ayuusweetfish/Tuengel/misc/protocol.txt

Packet format
[1 byte] Payload length (n)
[n byte] Payload
[4 byte] CRC-32 0x04C11DB7 little-endian

(All offsets hexadecimal)

Serial - L0
Ping
  +00 [0x55] Ping
  Response
    +00 [0xAA] Pong
    For n in 0~4
    +3n+01 Bitmask  7~ 0
    +3n+02 Bitmask 15~ 8
    +3n+03 Bitmask 23~16
Strike
  +00 [0x00~0x3F] Out addr (L1)
  +01 [0x00~0x3F] Out addr (U)
  +02 Velocity
  Response
    +00 [0xAA] Done
        [0xAB] Another operation in progress, ignored
        [0xED] Timeout/error at downstream
        [0xEE] Timeout/error

L0 - L1
Ping
  +00 [0x55] Ping
  Response
    +00 [0xAA] Pong
    +01 Bitmask  7~ 0
    +02 Bitmask 15~ 8
    +03 Bitmask 23~16
Strike
  +00 [0x00~0x3F] Out addr (U)
  +01 Velocity
  Response
    +00 [0xAA] Done
        [0xAB] Another operation in progress, ignored
        [0xEE] Timeout/error

L1 - U
Ping
+00 [0x55] Ping
  Response
    +00 [0xAA] Pong
    +01..10 UID
Strike
  +00 [0x01] Strike
  +01 Velocity
  Response
    +00 [0xAA] Done
        [0xAB] Another operation in progress, ignored
