ayuusweetfish/Tuengel/unit_hw/Case_Unit.kicad_pcb

## KiCad design unit_hw/Case_Unit.kicad_pcb (2024-10-16)

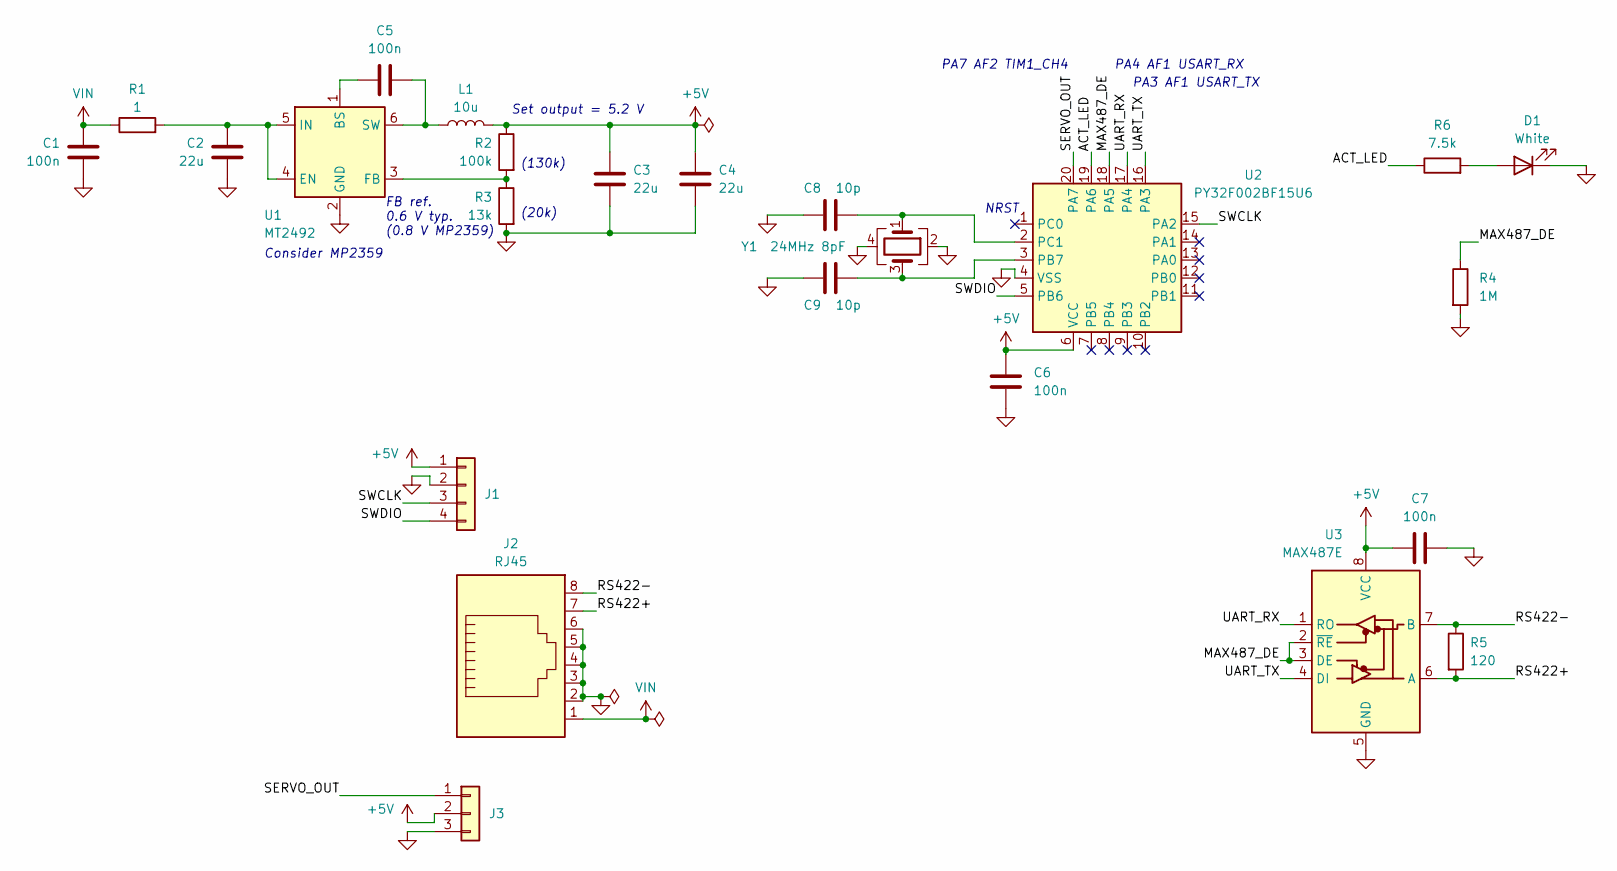
[picture p1: schematic Case_Unit.kicad_sch]

Parts:
C1, C5, C6, C7: 100n; C_0402_1005Metric
C2, C3, C4: 22u; C_0603_1608Metric
C8, C9: 10p; C_0402_1005Metric
D1: White; LED_0603_1608Metric
J1: Conn_01x04; TestPoints_1x04_P2.0
J2: RJ45; RJ45_OST_PJ012-8P8CX_Vertical
J3: Conn_01x03; PinHeader_1x03_P2.54mm_Vertical
L1: 10u; L_Changjiang_FNR5030S
R1: 1; R_0402_1005Metric
R2: 100k; R_0402_1005Metric
R3: 13k; R_0402_1005Metric
R4: 1M; R_0402_1005Metric
R5: 120; R_0402_1005Metric
R6: 7.5k; R_0402_1005Metric
U1: MT2492; SOT-23-6; Manufacturer_Part_Number MT2492
U2: PY32F002BF15U6; QFN-20-1EP_3x3mm_P0.4mm_EP1.65x1.65mm
U3: MAX487E; SOIC-8_3.9x4.9mm_P1.27mm
Y1: 24MHz 8pF; Crystal_SMD_2016-4Pin_2.0x1.6mm

Connections:
+5V: C3.1, C4.1, C6.1, C7.1, J1.1, J3.2, L1.2, R2.1, U2.6 (VCC), U3.8 (VCC)
/ACT_LED: R6.1, U2.19 (PA6)
/MAX487_DE: R4.1, U2.18 (PA5), U3.2 (~RE), U3.3 (DE)
/RS422+: J2.7, R5.2, U3.6 (A)
/RS422-: J2.8, R5.1, U3.7 (B)
/SERVO_OUT: J3.1, U2.20 (PA7)
/SWCLK: J1.3, U2.15 (PA2)
/SWDIO: J1.4, U2.5 (PB6)
/UART_RX: U2.17 (PA4), U3.1 (RO)
/UART_TX: U2.16 (PA3), U3.4 (DI)
GND: C1.2, C2.2, C3.2, C4.2, C6.2, C7.2, C8.1, C9.1, D1.1 (K), J1.2, J2.2, J2.3, J2.4, J2.5, J2.6, J3.3, R3.2, R4.2, U1.2 (GND), U2.4 (VSS), U2.21 (PAD), U3.5 (GND), Y1.2, Y1.4
unnamed: D1.2 (A), R6.2
unnamed: C5.1, U1.1 (BS)
unnamed: C2.1, R1.2, U1.4 (EN), U1.5 (IN)
unnamed: R2.2, R3.1, U1.3 (FB)
unnamed: C5.2, L1.1, U1.6 (SW)
unnamed: C9.2, U2.3 (PB7), Y1.3
unnamed: C8.2, U2.2 (PC1), Y1.1
VIN: C1.1, J2.1, R1.1

Notes on the sheet:
PA4 AF1 USART_RX
Consider MP2359
(130k)
NRST
PA3 AF1 USART_TX
FB ref. 0.6 V typ. (0.8 V MP2359)
(20k)
PA7 AF2 TIM1_CH4
Set output = 5.2 V

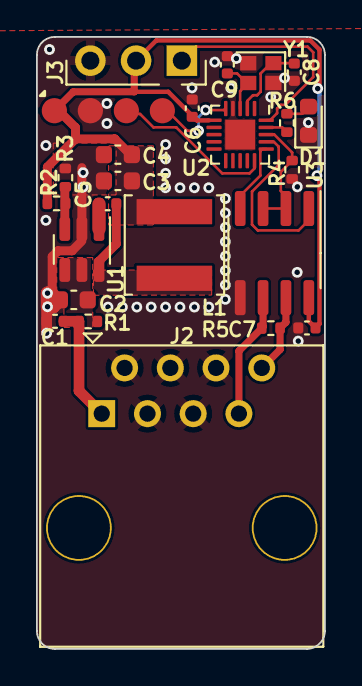
[picture p2: board Case_Unit.kicad_pcb from above]

Board: 2 copper layers, 16.0 x 34.0 mm, 24 parts (0 on the bottom side), 19 nets.
