ayuusweetfish/Tuengel/subt_hw/Case_Subt.kicad_pcb

## KiCad design subt_hw/Case_Subt.kicad_pcb (2024-10-15)

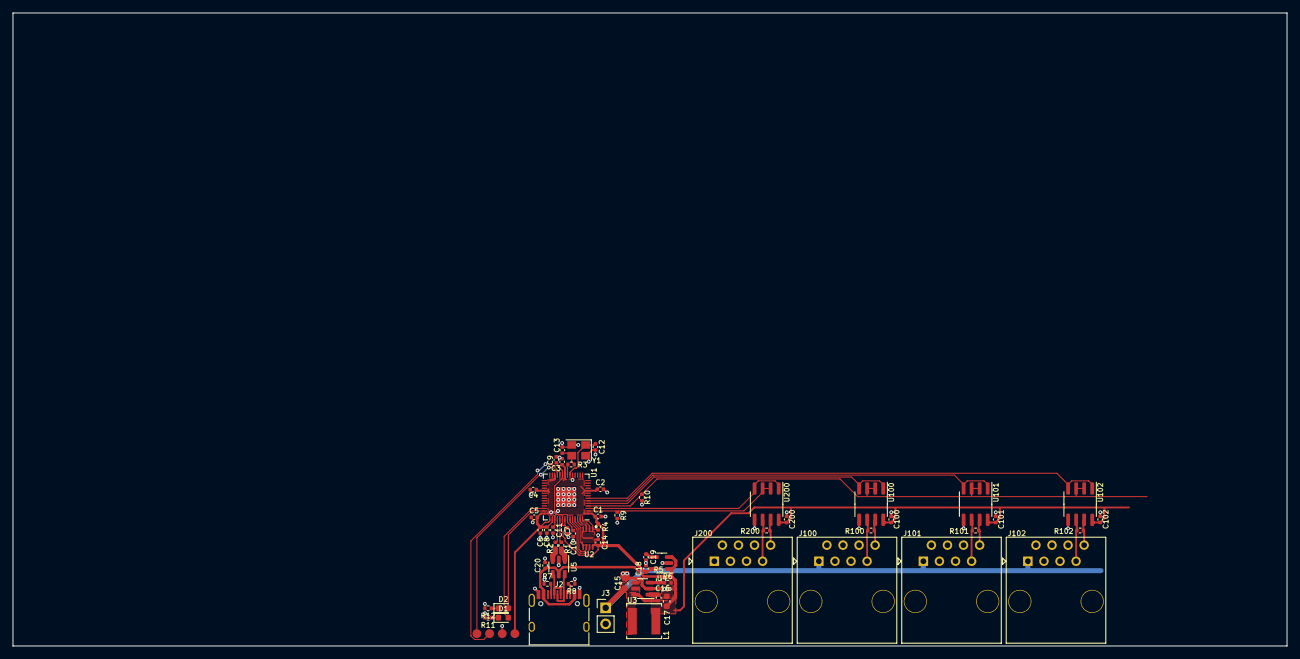
[picture p3: board Case_Subt.kicad_pcb from above]

Board: 2 copper layers, 201.3 x 100.0 mm, 60 parts (0 on the bottom side), 46 nets.

Parts:
C1, C2, C3, C4, C5, C6, C7, C9, C10, C14, C20, C100, C101, C102, C200: 100n; C_0402_1005Metric
C8, C11: 1u; C_0402_1005Metric
C12, C13: 27p; C_0402_1005Metric
C15, C17: 22u; C_0603_1608Metric
C16: 22n; C_0402_1005Metric
C18: 4.7u; C_0402_1005Metric
C19: 10n; C_0402_1005Metric
D1: Pink; LED_0603_1608Metric
D2: Violet; LED_0603_1608Metric
J1: P2.00 01x04; TestPoints_1x04_P2.0
J2: USB_C_Receptacle_USB2.0_14P; USB_C_Receptacle_HRO_TYPE-C-31-M-12
J3: Conn_01x02; PinHeader_1x02_P2.54mm_Vertical
J100, J101, J102, J200: RJ45; RJ45_OST_PJ012-8P8CX_Vertical
L1: 10u; L_Changjiang_FNR5030S
R1, R2: 22; R_0402_1005Metric
R3: 1k TBD; R_0402_1005Metric
R4, R5: 100k; R_0402_1005Metric
R6: 22k; R_0402_1005Metric
R7, R8: 5.1k; R_0402_1005Metric
R9, R10: 1M; R_0402_1005Metric
R11, R12: 7.5k; R_0402_1005Metric
R100, R101, R102, R200: 120; R_0402_1005Metric
U1: RP2040; QFN-56-1EP_7x7mm_P0.4mm_EP3.2x3.2mm
U2: W25Q16JVUXIQ; SON50P300X200X60-9N
U3: MT2492; SOT-23-6
U4: SPX3819M5-L-3-3; SOT-23-5
U5: USBLC6-2SC6; SOT-23-6
U100, U101, U102, U200: MAX487E; SOIC-8_3.9x4.9mm_P1.27mm
Y1: 12MHz; Crystal_SMD_3225-4Pin_3.2x2.5mm

Connections:
+3V3: C1.1, C2.1, C3.1, C4.1, C5.1, C6.1, C7.1, C8.1, C14.1, C18.1, J1.1, R4.2, U1.1 (IOVDD), U1.10 (IOVDD), U1.22 (IOVDD), U1.26 (RUN), U1.33 (IOVDD), U1.42 (IOVDD), U1.43 (ADC_AVDD), U1.44 (VREG_IN), U1.48 (USB_VDD), U1.49 (IOVDD), U2.8 (VCC), U4.5 (OUT)
+5V: C17.1, C20.1, C100.1, C101.1, C102.1, C200.1, J2.A4 (VBUS), J2.A9 (VBUS), J2.B4 (VBUS), J2.B9 (VBUS), L1.2, R5.1, U4.1 (IN), U4.3 (EN), U5.5 (VBUS), U100.8 (VCC), U101.8 (VCC), U102.8 (VCC), U200.8 (VCC)
/ACT1: D1.2 (A), U1.40 (GPIO28_ADC2)
/ACT2: D2.2 (A), U1.41 (GPIO29_ADC3)
/DATA_00: U1.5 (GPIO3), U100.1 (RO), U100.4 (DI)
/DATA_01: U1.6 (GPIO4), U101.1 (RO), U101.4 (DI)
/DATA_02: U1.7 (GPIO5), U102.1 (RO), U102.4 (DI)
/DATA_IN: U1.3 (GPIO1), U200.1 (RO), U200.4 (DI)
/DE_ALL: R10.1, U1.4 (GPIO2), U100.2 (~RE), U100.3 (DE), U101.2 (~RE), U101.3 (DE), U102.2 (~RE), U102.3 (DE)
/DE_IN: R9.1, U1.2 (GPIO0), U200.2 (~RE), U200.3 (DE)
/FLASH_CS: R4.1, U1.56 (QSPI_SS), U2.1 (~CS)
/FLASH_D0: U1.53 (QSPI_SD0), U2.5 (DI_(IO0))
/FLASH_D1: U1.55 (QSPI_SD1), U2.2 (DO_(IO1))
/FLASH_D2: U1.54 (QSPI_SD2), U2.3 (~WP_(IO2))
/FLASH_D3: U1.51 (QSPI_SD3), U2.7 (~HOLD_OR_RESET_(IO3))
/FLASH_SCK: U1.52 (QSPI_SCLK), U2.6 (CLK)
/In_Conn/DATA+: J200.7, R200.2, U200.6 (A)
/In_Conn/DATA-: J200.8, R200.1, U200.7 (B)
/Out_00/DATA+: J100.7, R100.2, U100.6 (A)
/Out_00/DATA-: J100.8, R100.1, U100.7 (B)
/Out_01/DATA+: J101.7, R101.2, U101.6 (A)
/Out_01/DATA-: J101.8, R101.1, U101.7 (B)
/Out_02/DATA+: J102.7, R102.2, U102.6 (A)
/Out_02/DATA-: J102.8, R102.1, U102.7 (B)
/SWCLK: J1.3, U1.24 (SWCLK)
/SWDIO: J1.4, U1.25 (SWD)
/USB_D+: R1.1, U5.1 (I/O1)
/USB_D-: R2.1, U5.3 (I/O2)
/USB_RAW_D+: J2.A6 (D+), J2.B6 (D+), U5.6 (I/O1)
/USB_RAW_D-: J2.A7 (D-), J2.B7 (D-), U5.4 (I/O2)
GND: C1.2, C2.2, C3.2, C4.2, C5.2, C6.2, C7.2, C8.2, C9.2, C10.2, C11.2, C12.1, C13.1, C14.2, C15.2, C17.2, C18.2, C19.2, C20.2, C100.2, C101.2, C102.2, C200.2, J1.2, J2.A1 (GND), J2.A12 (GND), J2.B1 (GND), J2.B12 (GND), J3.2, J100.2, J100.3, J100.4, J100.5, J100.6, J101.2, J101.3, J101.4, J101.5, J101.6, J102.2, J102.3, J102.4, J102.5, J102.6, J200.2, J200.3, J200.4, J200.5, J200.6, R6.2, R7.1, R8.1, R9.2, R10.2, R11.2, R12.2, U1.19 (TESTEN), U1.57 (GND), U2.4 (GND), U2.9 (EP), U3.2 (GND), U4.2 (GND), U5.2 (GND), U100.5 (GND), U101.5 (GND), U102.5 (GND), U200.5 (GND), Y1.2, Y1.4
unnamed: C13.2, R3.1, Y1.3
unnamed: D1.1 (K), R11.1
unnamed: D2.1 (K), R12.1
unnamed: J2.A5 (CC1), R7.2
unnamed: J2.B5 (CC2), R8.2
unnamed: R2.2, U1.46 (USB_DM)
unnamed: R1.2, U1.47 (USB_DP)
unnamed: C12.2, U1.20 (XIN), Y1.1
unnamed: R3.2, U1.21 (XOUT)
unnamed: C16.1, U3.1 (BS)
unnamed: R5.2, R6.1, U3.3 (FB)
unnamed: C16.2, L1.1, U3.6 (SW)
unnamed: C19.1, U4.4 (BP)
VCORE: C9.1, C10.1, C11.1, U1.23 (DVDD), U1.45 (VREG_VOUT), U1.50 (DVDD)
VIN: C15.1, J3.1, J100.1, J101.1, J102.1, U3.4 (EN), U3.5 (IN)
