ayuusweetfish/Tuengel/hw_main/Case_Main.kicad_pcb

## KiCad design hw_main/Case_Main.kicad_pcb (2024-10-12)

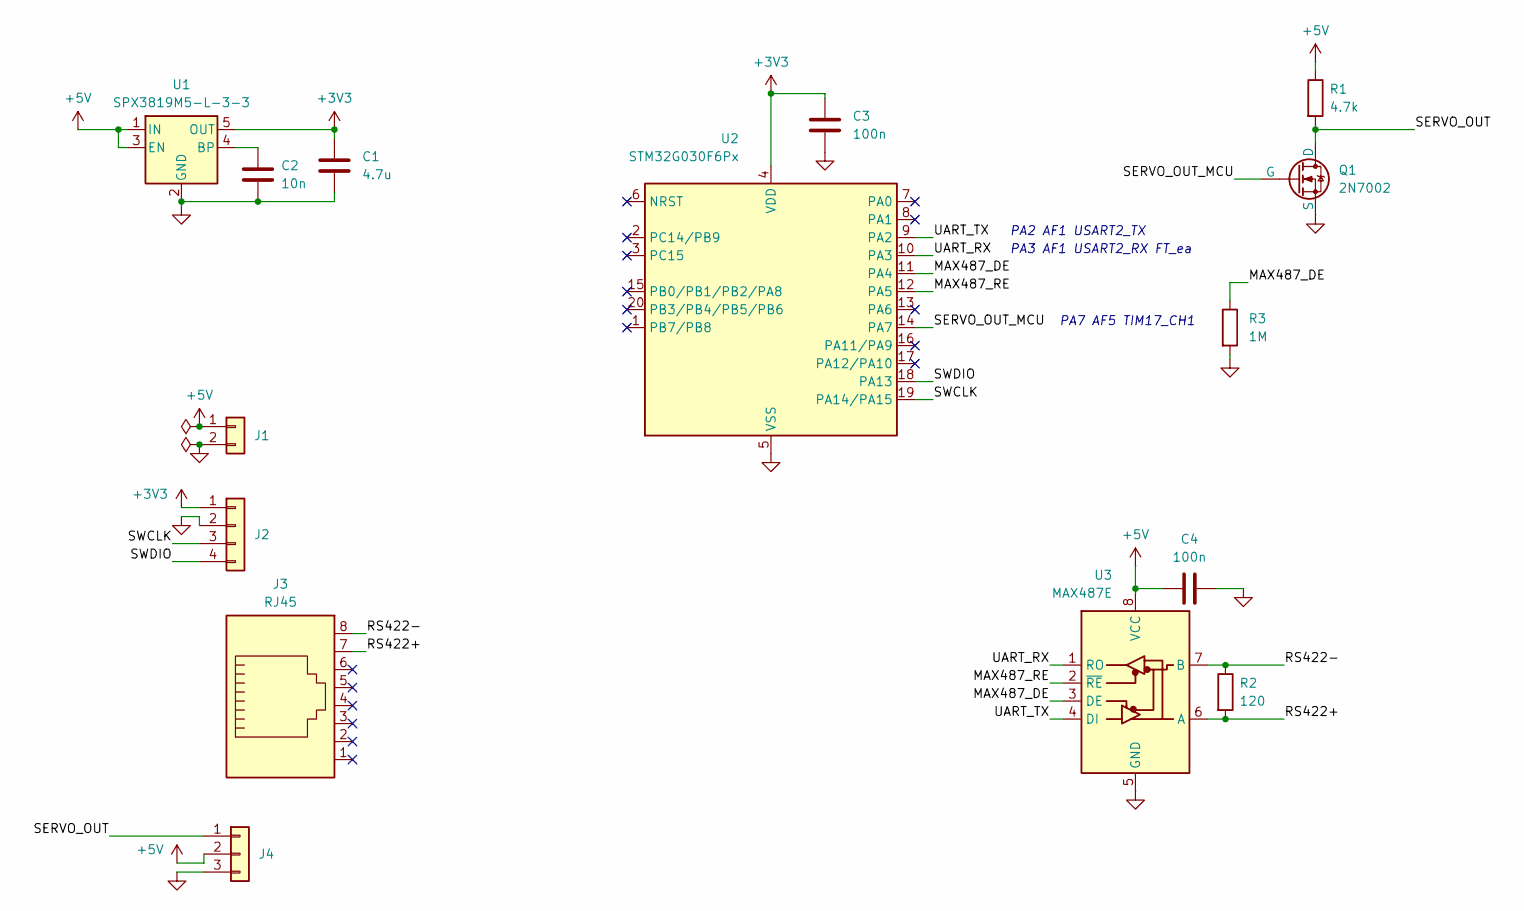
[picture p4: schematic Case_Main.kicad_sch]

Parts:
C1: 4.7u; C_0402_1005Metric
C2: 10n; C_0402_1005Metric
C3, C4: 100n; C_0402_1005Metric
J1: Conn_01x02; PinHeader_1x02_P2.54mm_Vertical
J2: Conn_01x04; TestPoints_1x04_P2.0
J3: RJ45; RJ45_OST_PJ012-8P8CX_Vertical
J4: Conn_01x03; PinHeader_1x03_P2.54mm_Vertical
Q1: 2N7002; SOT-23
R1: 4.7k; R_0402_1005Metric
R2: 120; R_0402_1005Metric
R3: 1M; R_0402_1005Metric
U1: SPX3819M5-L-3-3; SOT-23-5
U2: STM32G030F6Px; TSSOP-20_4.4x6.5mm_P0.65mm
U3: MAX487E; SOIC-8_3.9x4.9mm_P1.27mm

Connections:
+3V3: C1.1, C3.1, J2.1, U1.5 (OUT), U2.4 (VDD)
+5V: C4.1, J1.1, J4.2, R1.1, U1.1 (IN), U1.3 (EN), U3.8 (VCC)
/MAX487_DE: R3.1, U2.11 (PA4), U3.3 (DE)
/MAX487_RE: U2.12 (PA5), U3.2 (~RE)
/RS422+: J3.7, R2.2, U3.6 (A)
/RS422-: J3.8, R2.1, U3.7 (B)
/SERVO_OUT: J4.1, Q1.3 (D), R1.2
/SERVO_OUT_MCU: Q1.1 (G), U2.14 (PA7)
/SWCLK: J2.3, U2.19 (PA14/PA15)
/SWDIO: J2.4, U2.18 (PA13)
/UART_RX: U2.10 (PA3), U3.1 (RO)
/UART_TX: U2.9 (PA2), U3.4 (DI)
GND: C1.2, C2.2, C3.2, C4.2, J1.2, J2.2, J4.3, Q1.2 (S), R3.2, U1.2 (GND), U2.5 (VSS), U3.5 (GND)
unnamed: C2.1, U1.4 (BP)

Notes on the sheet:
PA3 AF1 USART2_RX FT_ea
PA2 AF1 USART2_TX
PA7 AF5 TIM17_CH1

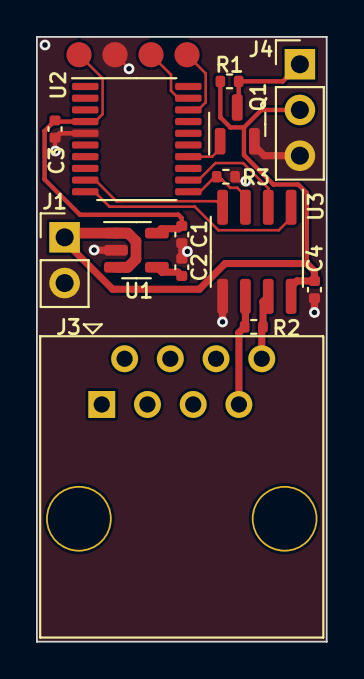
[picture p5: board Case_Main.kicad_pcb from above]

Board: 2 copper layers, 16.1 x 33.6 mm, 15 parts (0 on the bottom side), 14 nets.
