ayuusweetfish/Tuengel/(commit log)

2024-10-12 🎉 Mallet unit, submit for fab (Rev. 1)
    [Case_Main.kicad_pcb, Case_Main.kicad_sch]
2024-10-13 Start subtree schematic
    [Case_Subt.kicad_pcb, Case_Subt.kicad_sch]
2024-10-13 Rename main -> unit
    [Case_Unit.kicad_pcb, Case_Unit.kicad_sch]
2024-10-13 Add all 16 ports
    [Case_Subt.kicad_sch, Out_Conn.kicad_sch]
2024-10-13 Simplify wiring
    [Case_Subt.kicad_sch, Port.kicad_sch]
2024-10-14 Add servo testrun firmware
2024-10-14 More motor movements
2024-10-14 Remap servo signal to PB1
2024-10-14 Servo signals through timer PWM
2024-10-15 🚧 Router board
2024-10-15 🚧 Layout, without the final stretch
    [Case_Subt.kicad_pcb, Case_Subt.kicad_sch]
2024-10-15 Finish subtree/router board design
    [Case_Subt.kicad_sch, Port.kicad_sch]
2024-10-15 Revise unit schematic
    [Case_Unit.kicad_pcb, Case_Unit.kicad_sch]
2024-10-15 Submit for fab (Rev. 2 unit)
    [Case_Unit.kicad_pcb, Case_Unit.kicad_sch]
2024-10-16 Update testrun firmware to match board Rev. 1
2024-10-16 Revise unit board (change PY32 model to 002B; add crystal)
    [Case_Unit.kicad_pcb, Case_Unit.kicad_sch]
2024-10-16 Finish unit redesign; submit for fab (Rev. 2 unit)
    [Case_Unit.kicad_pcb, Case_Unit.kicad_sch]
2024-10-17 🎉 Subtree firmware test with Pico SDK 2.0.0
2024-10-17 Switch to CRC-32 (LSB first)
2024-10-17 Correctly receive packets and verify checksums
    [main.c]
2024-10-19 Fix serial stuck/missing data when too fast
    [main.c]
2024-10-20 Add UART PIO program (untested)
2024-10-20 TX through USB or UART depending on data source
    🚧 Missing commands (whole packets) with UART?
    [main.c]
2024-10-20 Refactor and fix potential timing issues with half duplex
    [main.c]
2024-10-20 Update subtree hardware with actual values in assembly
    [Case_Subt.kicad_sch]
2024-10-20 Fix flash script; upload to actual board!
    [main.c]
2024-10-20 🎉 Unit blinking firmware
2024-10-20 Drive servo motor with PY32
2024-10-21 Add RS-422 serial communication (🚧 untested)
2024-10-21 Update unit hardware document with actual values in assembly
    [Case_Subt.kicad_sch]
2024-10-21 Working UART through RS-422 (unit)
2024-10-22 🎉 Send data to units
2024-10-22 🚧 Trembling communications established between subtree and unit
2024-10-22 Fix downstream-facing port not transmitting
    [main.c]
2024-10-22 Correctly sending to switchable downstream ports
    [main.c]
2024-10-23 Shorten waits between transmissions
    [main.c]
2024-10-23 unit: Switch to byte-based processing, achieving auto-recovery from errors
    [main.c]
2024-10-23 subt: Filter spurious signal noise in PIO UART
2024-10-23 unit: Implement velocity parameter
2024-10-23 unit: Revise activity LED pattern, finalise firmware
2024-10-23 unit: Fix activity LED pattern not indicating received messages
    [main.c]
2024-10-24 More granular error messages, 🚧 velocity only 0x7A~0xFD possible?
    [main.c]
2024-10-24 subt: Support omitting velocity in serial command
2024-10-24 subt: Finalise firmware for now 🎉
2024-10-24 Print sent data & checksum in serial utility
2024-10-25 Add TCP-serial relay
2024-10-26 relay: Build libserialport for Windows
2024-10-26 relay: Forward network traffic to serial
2024-10-26 relay: Forward data received from serial to TCP
2024-10-26 relay: Fix Windows build
    [main.c]
2024-10-27 relay: Support command line arguments
2024-10-27 relay: Read arguments from file when none is present
2024-10-27 relay: Fix incorrect reallocation
    [main.c]
2024-10-27 relay: Debug switch
2024-10-27 relay: Add debug/dump switch and build hash/date
2024-10-28 relay: Enable DTR, prepare for global retry?
2024-10-28 relay: Add auto-loop bat
2024-10-28 relay: Add a filter function before TX
2024-10-28 relay: Delayed transmission
2024-10-28 relay: Translate commands
2024-10-28 relay: Fix incorrect unit address mapping
    [main.c]
2024-10-28 relay: Adjust random patterns
2024-10-28 🎉 Finalise firmware release
